joeostrander/gameBadge/PCB 2022 version/revB/watch_game_2022_revB.brd

## EAGLE design PCB 2022 version/revB/watch_game_2022_revB.brd (2024-01-11, an earlier design)

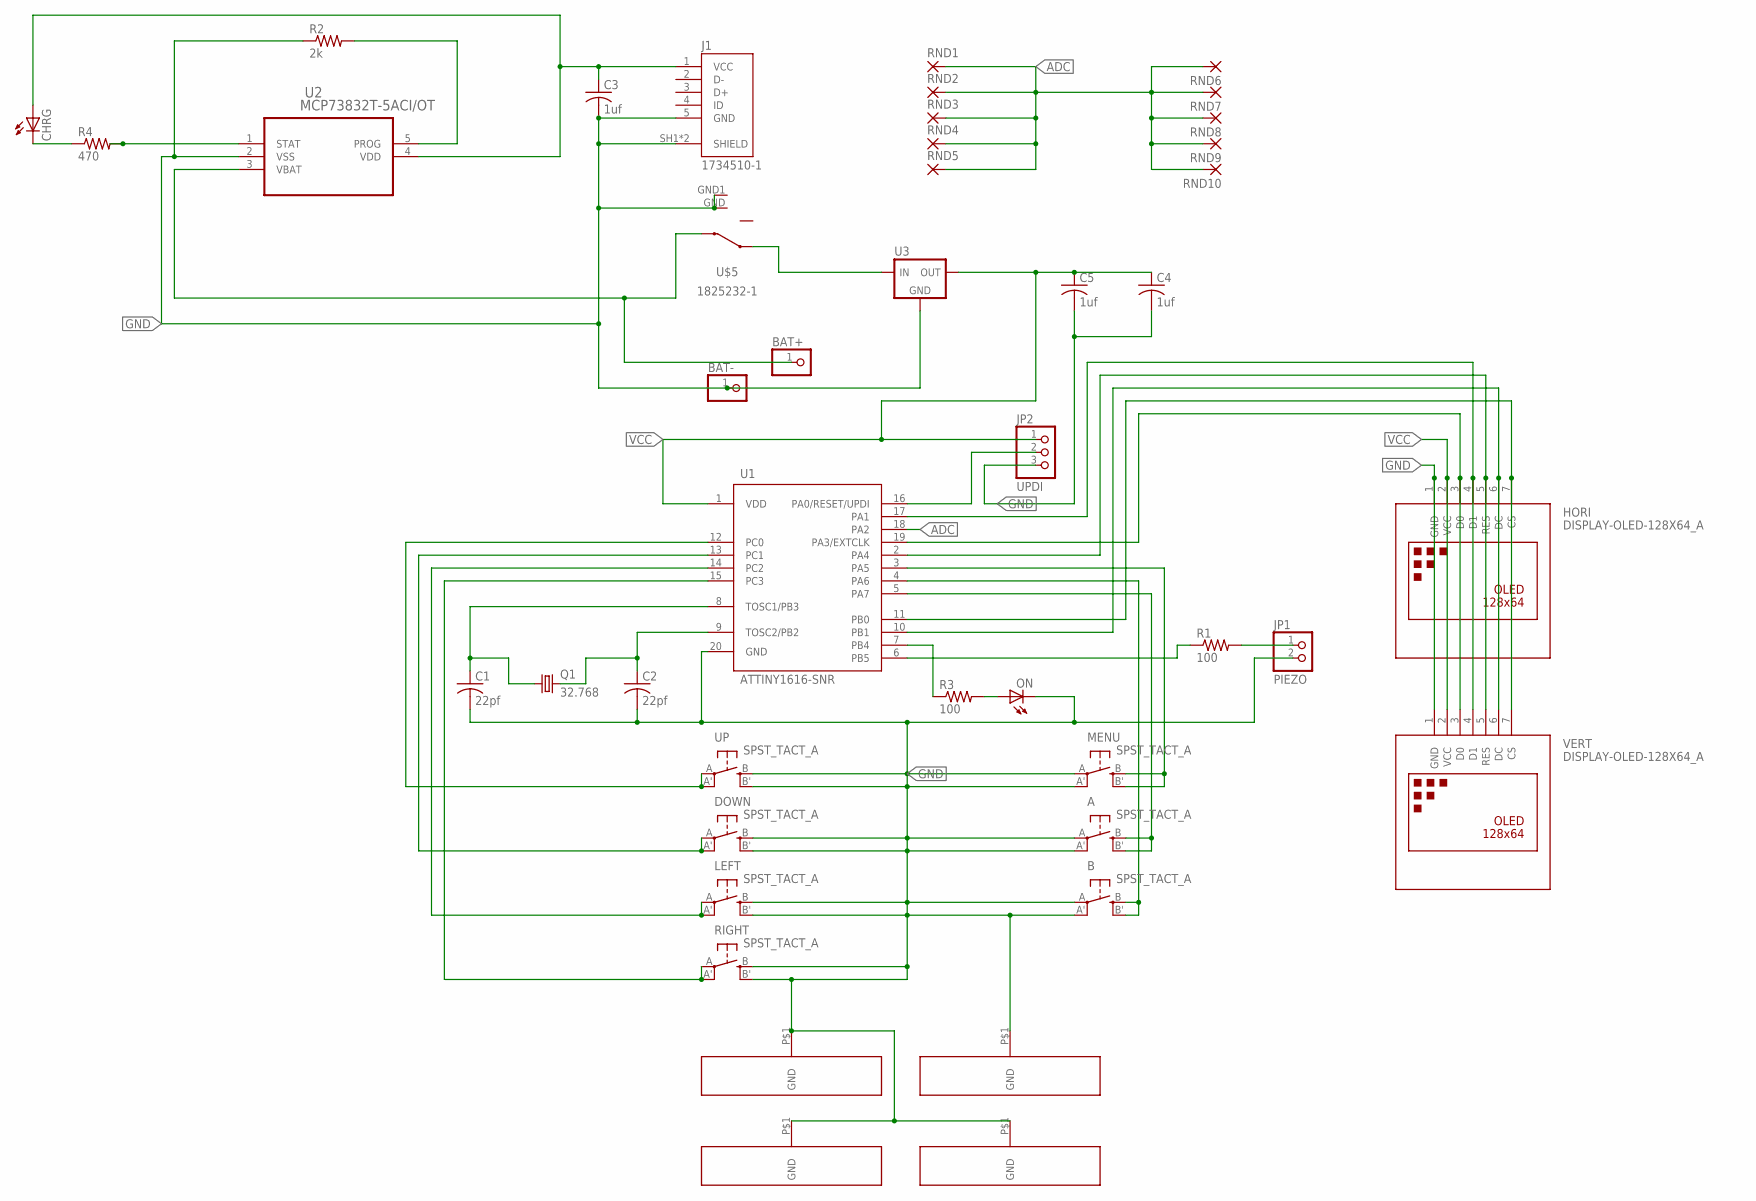
[picture p1: schematic watch_game_2022_revB.sch]

Parts:
A: SPST_TACT_A; EVQ-Q2_A
B: SPST_TACT_A; EVQ-Q2_A
BAT+: PINHD-1X1; 1X01
BAT-: PINHD-1X1; 1X01
C1, C2: 22pf; C0805
C3, C4, C5: 1uf; C0805
CHRG: LED3MM
DOWN: SPST_TACT_A; EVQ-Q2_A
HORI: DISPLAY-OLED-128X64_A
J1: 1734510-1; TE_1734510-1
JP1: PIEZO; 1X02
JP2: UPDI; 1X03
LEFT: SPST_TACT_A; EVQ-Q2_A
MENU: SPST_TACT_A; EVQ-Q2_A
ON: LED5MM
Q1: 32.768; TC26H
R1, R3: 100; M0805
R2: 2k; M0805
R4: 470; M0805
RIGHT: SPST_TACT_A; EVQ-Q2_A
RND1, RND2, RND3, RND4, RND5, RND6, RND7, RND8, RND9, RND10: SMD5; SMD2,54-5,08
U1: ATTINY1616-SNR; SOIC127P1032X265-20N
U2: MCP73832T-5ACI/OT; SOT95P300X145-5N
U3: NCP5501DT33RKG; DPAK
U$5: 1825232-1
U$6, U$7, U$8, U$9: GND_STRIP_600MIL; GND_PADS_2
UP: SPST_TACT_A; EVQ-Q2_A
VERT: DISPLAY-OLED-128X64_A

Connections:
ADC: RND1.1, RND2.1, RND3.1, RND4.1, RND5.1, RND6.1, RND7.1, RND8.1, RND9.1, RND10.1, U1.18 (PA2)
GND: A.A, A.A' (P1), B.A, B.A' (P1), BAT-.1, C1.2, C2.2, C3.2, C4.2, C5.2, DOWN.B (S), DOWN.B' (S1), HORI.1 (GND), J1.5 (GND), J1.SH1 (SHIELD), J1.SH2 (SHIELD), JP1.2, JP2.3, LEFT.B (S), LEFT.B' (S1), MENU.A, MENU.A' (P1), ON.K (C), R2.1, RIGHT.B (S), RIGHT.B' (S1), U1.20 (GND), U2.2 (VSS), U3.4 (GND), U$5.GND, U$5.GND1, U$6.P$1, U$7.P$1, U$8.P$1, U$9.P$1, UP.B (S), UP.B' (S1), VERT.1 (GND)
unnamed: U1.12 (PC0), UP.A, UP.A' (P1)
unnamed: DOWN.A, DOWN.A' (P1), U1.13 (PC1)
unnamed: LEFT.A, LEFT.A' (P1), U1.14 (PC2)
unnamed: RIGHT.A, RIGHT.A' (P1), U1.15 (PC3)
unnamed: B.B (S), B.B' (S1), U1.4 (PA6)
unnamed: HORI.3 (D0), U1.19 (PA3/EXTCLK), VERT.3 (D0)
unnamed: R3.1, U1.7 (PB4)
unnamed: JP1.1, R1.2
unnamed: C3.1, CHRG.A, J1.1 (VCC), U2.4 (VDD)
unnamed: U3.1 (VIN), U$5.3
unnamed: R4.2, U2.1 (STAT)
unnamed: BAT+.1, U2.3 (VBAT), U$5.2
unnamed: JP2.2, U1.16 (PA0/RESET/UPDI)
unnamed: HORI.4 (D1), U1.17 (PA1), VERT.4 (D1)
unnamed: HORI.5 (RES), U1.2 (PA4), VERT.5 (RES)
unnamed: MENU.B (S), MENU.B' (S1), U1.3 (PA5)
unnamed: ON.A, R3.2
unnamed: A.B (S), A.B' (S1), U1.5 (PA7)
unnamed: HORI.7 (CS), U1.11 (PB0), VERT.7 (CS)
unnamed: HORI.6 (DC), U1.10 (PB1), VERT.6 (DC)
unnamed: R1.1, U1.6 (PB5)
unnamed: C1.1, Q1.1, U1.8 (TOSC1/PB3)
unnamed: C2.1, Q1.2, U1.9 (TOSC2/PB2)
unnamed: R2.2, U2.5 (PROG)
unnamed: CHRG.K (C), R4.1
VCC: C4.1, C5.1, HORI.2 (VCC), JP2.1, U1.1 (VDD), U3.3 (VOUT), VERT.2 (VCC)

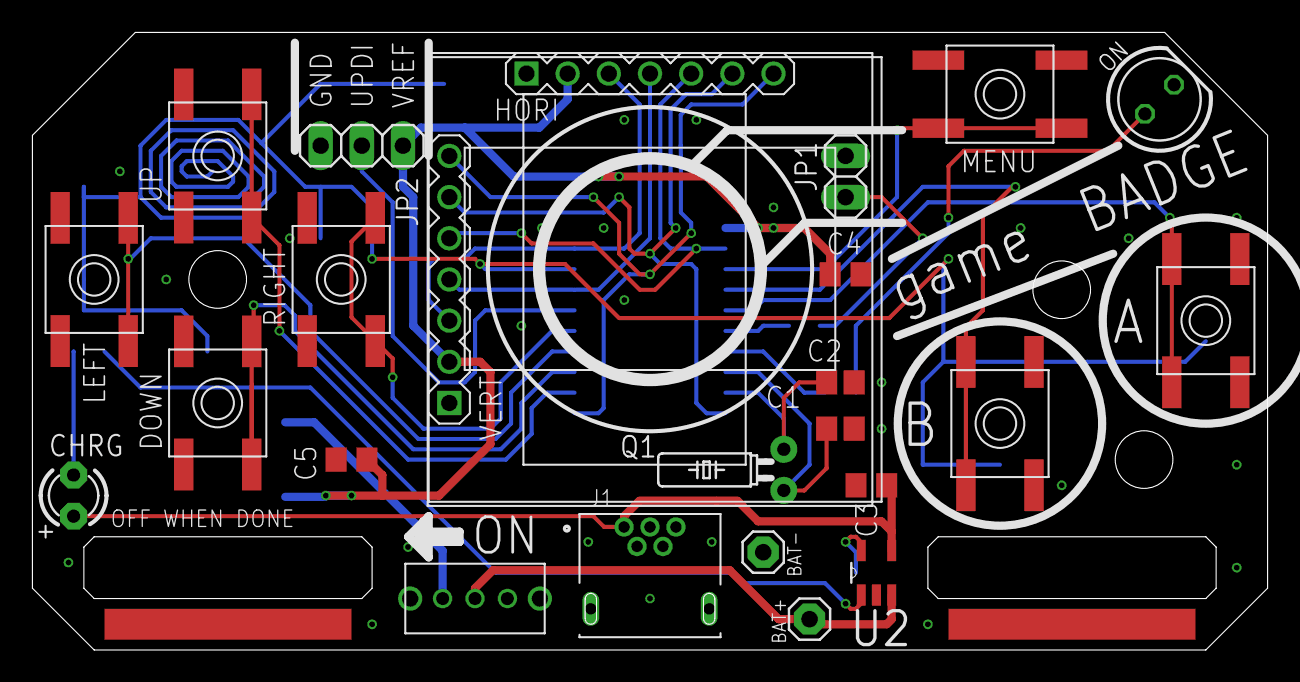
[picture p2: board watch_game_2022_revB.brd from above]

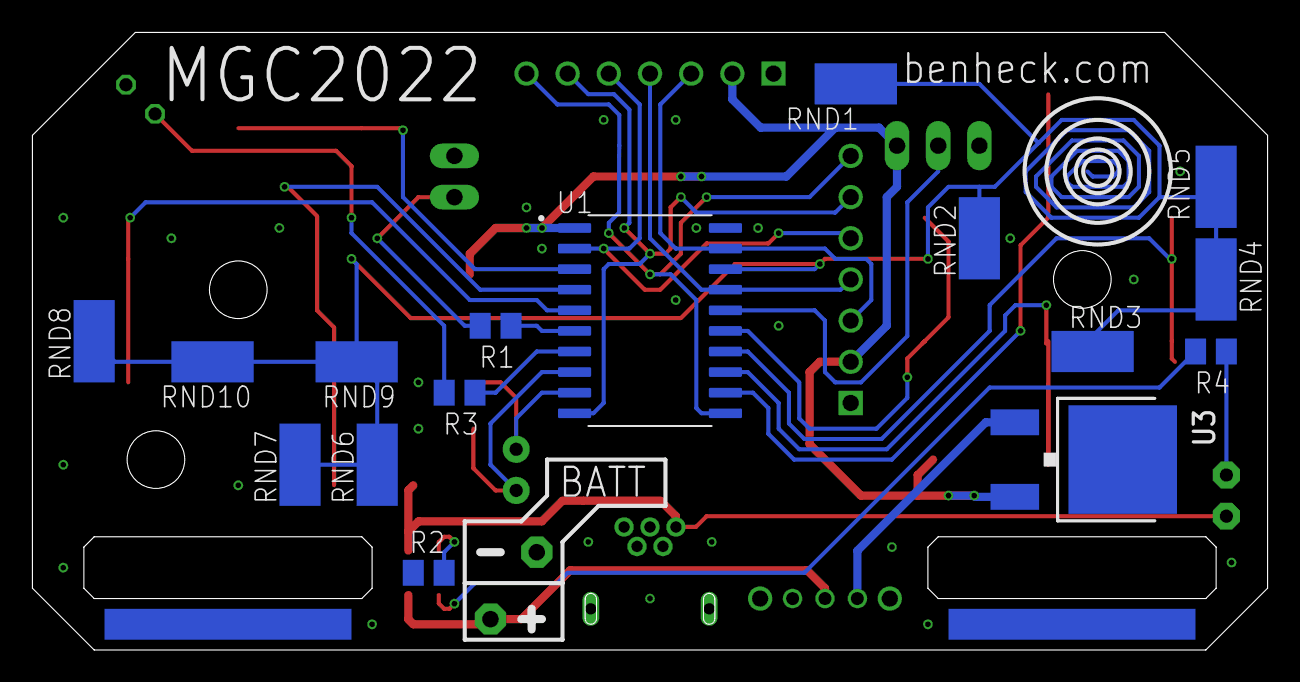
[picture p3: board watch_game_2022_revB.brd from below]

Board: 2 copper layers, 76.2 x 38.1 mm, 44 parts (18 on the bottom side), 28 nets.
