joeostrander/gameBadge/(commit log)

2024-01-05 initial conversion to platformio note - moon force works, mgc test app has a glitch
    [MGC Test App.componentinfo.xml, watch_game_2022_revB.sch]
2024-01-08 disable compiler link-time optimization flag revert to default compiler optimization level remove arduino framework definition (unneeded)
2024-01-11 added a rev C: - SMD LEDs - LM1117 3V3 regulator - Micro USB - alternate UPDI pinout - 12mm passive buzzer - EasyEDA layout
    [watch_game_2022_revB.brd, watch_game_2022_revB.sch, watch_game_2022_revC.csv]
